CoreElectronics/CE-PiicoDev-OLED-SSD1306/README.md

# PiicoDev® OLED Module SSD1306

This is the repo for the Core Electronics [PiicoDev OLED Module (128x64) SSD1306](https://core-electronics.com.au/catalog/product/view/sku/CE07911).

**Guides**

- for [Micro:bit](https://core-electronics.com.au/tutorials/micro-bit/piicodev-oled-ssd1306-microbit-guide.html)
- for [Raspberry Pi Pico](https://core-electronics.com.au/tutorials/raspberry-pi-pico/piicodev-oled-ssd1306-raspberry-pi-pico-guide.html)
- for [Raspberry Pi](https://core-electronics.com.au/tutorials/raspberry-pi/piicodev-oled-ssd1306-raspberry-pi-guide.html)

## License
This project is open source - please review the LICENSE.md file for further licensing information.

If you have any technical questions, or concerns about licensing, please contact technical support on the [Core Electronics forums](https://forum.core-electronics.com.au/).

*\"PiicoDev\" and the PiicoDev logo are trademarks of Core Electronics Pty Ltd.*
