CoreElectronics/CE-PiicoDev-OLED-SSD1306/Documents/schematic.pdf

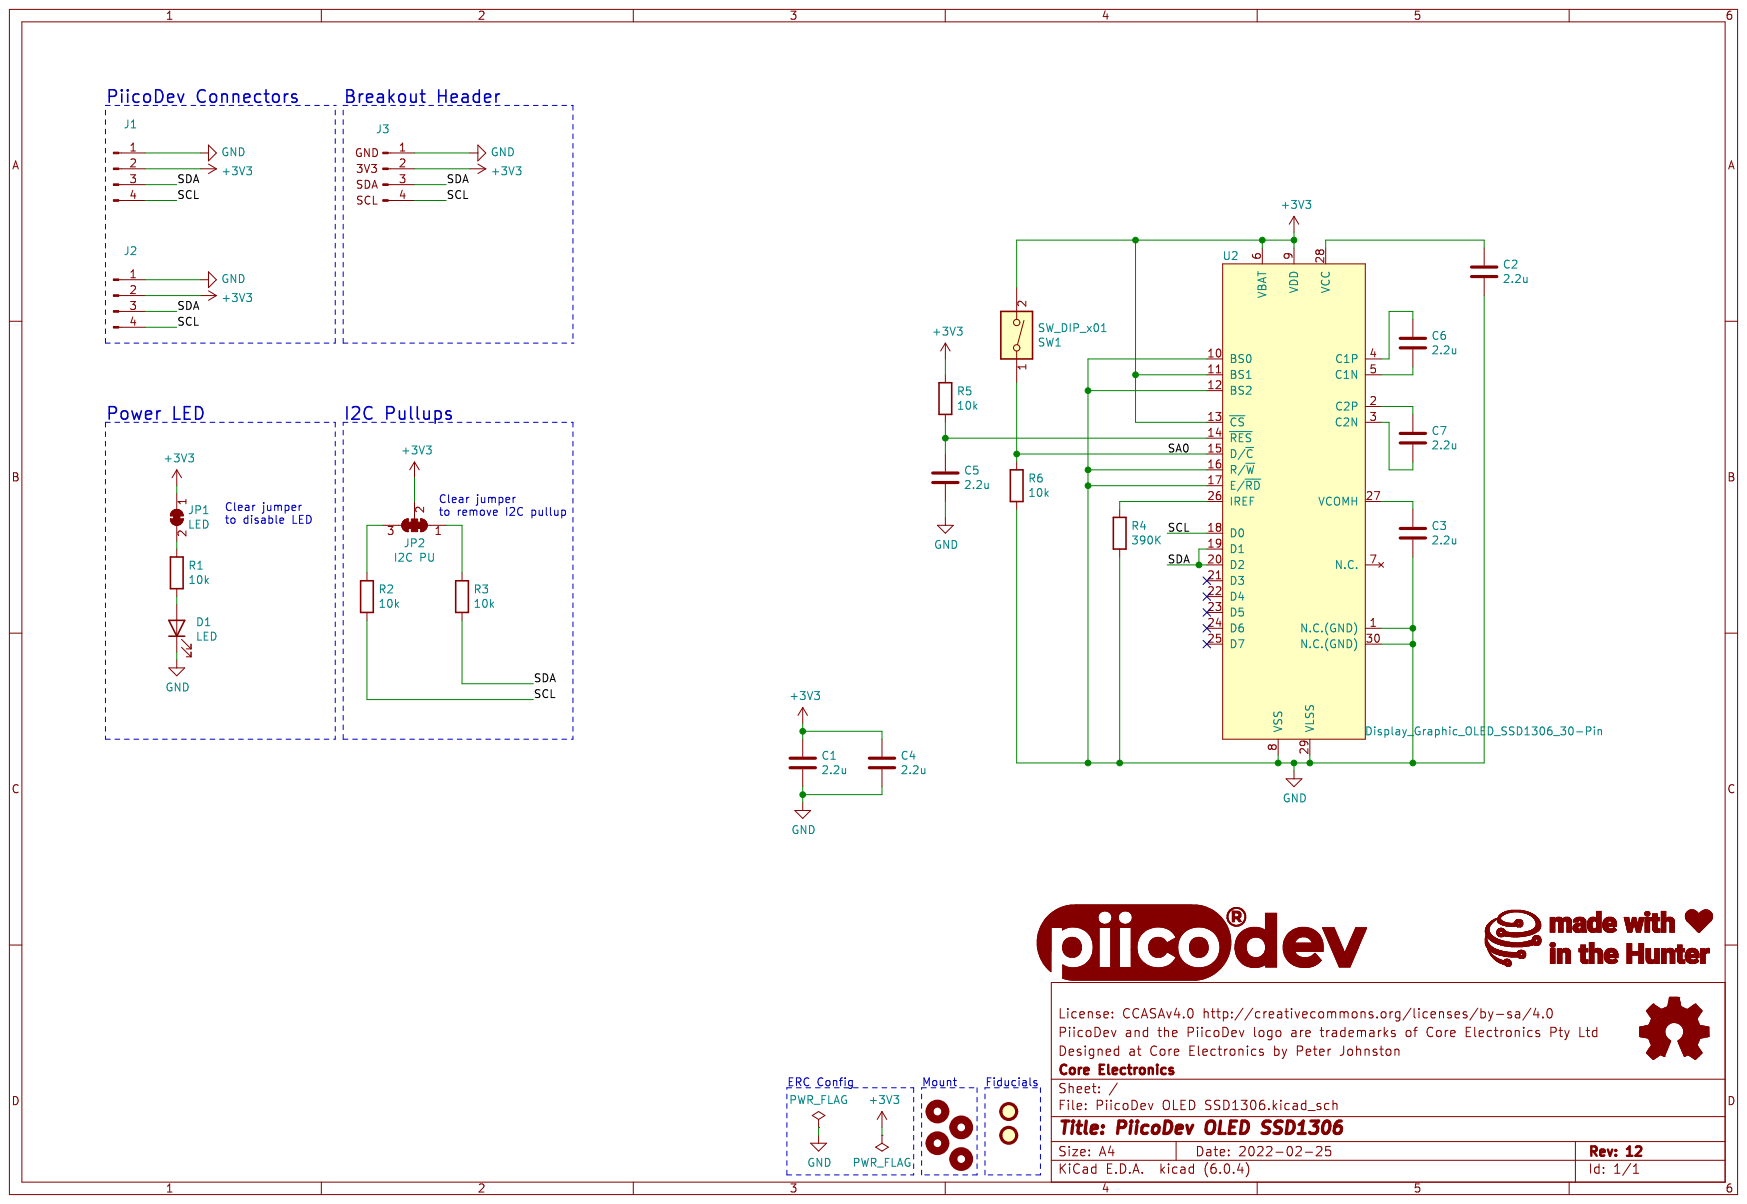
[picture p1: page 1]
