CoreElectronics/CE-PiicoDev-OLED-SSD1306/(commit log)

2021-07-09 Update Schematic & PCB
    [PiicoDev OLED SSD1306.kicad_pcb, PiicoDev OLED SSD1306.sch]
2021-07-20 Update PiicoDev OLED SSD1306.kicad_pcb
    [PiicoDev OLED SSD1306.kicad_pcb]
2021-08-18 Update version number
    [PiicoDev OLED SSD1306.kicad_pcb, PiicoDev OLED SSD1306.sch]
2021-08-19 Edge cut tweak
    [PiicoDev OLED SSD1306.kicad_pcb]
2021-08-20 Rotate PCB 90 degrees
    [PiicoDev OLED SSD1306.kicad_pcb, PiicoDev OLED SSD1306.sch]
2021-08-31 Rotate Open Hardware Symbol
    [PiicoDev OLED SSD1306.kicad_pcb]
2021-12-30 v11 Update
    Change resistor values
    Add DIP switch and remove ADR jumper
    Update graphic labels
    Update text formatting
    [PiicoDev OLED SSD1306.kicad_pcb, PiicoDev OLED SSD1306.sch]
2022-02-24 Update to KiCad 6.0
    [PiicoDev OLED SSD1306.kicad_pcb, PiicoDev OLED SSD1306.kicad_sch]
2022-02-24 Improve FFab layer
    [PiicoDev OLED SSD1306.kicad_pcb]
2022-02-25 Update Jumpers
    [PiicoDev OLED SSD1306.kicad_pcb, PiicoDev OLED SSD1306.kicad_sch]
2022-03-23 rotate ASW
    [PiicoDev OLED SSD1306.kicad_pcb, PiicoDev OLED SSD1306.kicad_sch]
2022-06-24 update to v13 with reduced paste on OLED
    [PiicoDev OLED SSD1306.kicad_pcb, PiicoDev OLED SSD1306.kicad_sch, PiicoDev OLED SSD1306.sch]
