CoreElectronics/CE-PiicoDev-OLED-SSD1306/(notices)

Notices in the files:
PCB/PiicoDev OLED SSD1306.kicad_sch:
License: CCASAv4.0 http://creativecommons.org/licenses/by-sa/4.0
